smontoyah/criogenia_GICM/README.md

Characterization System for Electronic Components under Cryogenic Conditions

For more information about this project, visit the [WIKI](https://github.com/smontoyah/criogenia_GICM/wiki)!
