smontoyah/criogenia_GICM/0.5cm_interfaz_3_minutos.png

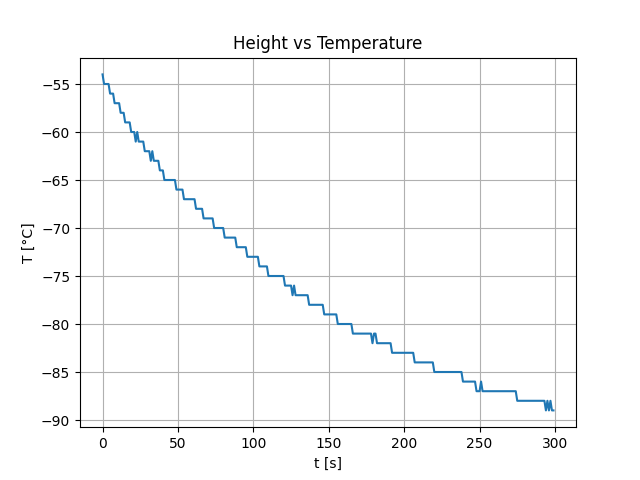
0.5cm_interfaz_3_minutos.png
