smontoyah/criogenia_GICM/0.5cm_interfaz_10min.png

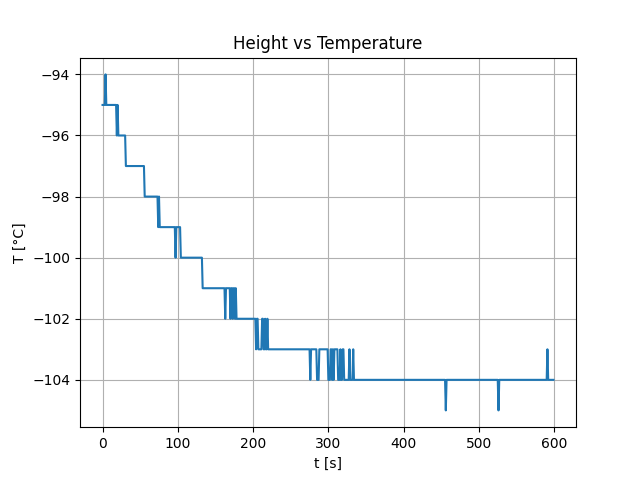
0.5cm_interfaz_10min.png
