smontoyah/criogenia_GICM/0.5cm_interfaz_20min.png

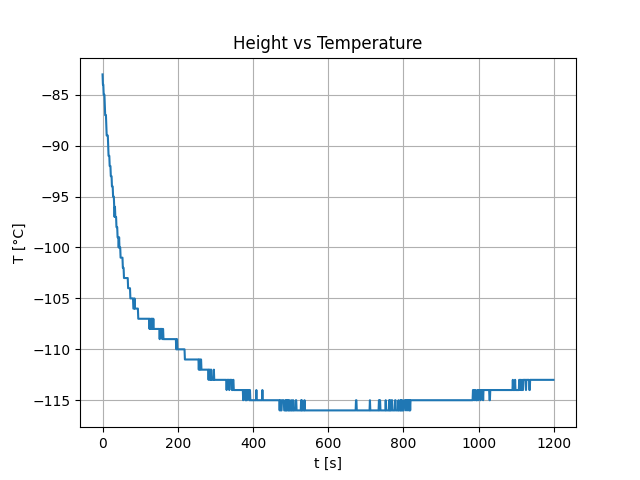
0.5cm_interfaz_20min.png
