smontoyah/criogenia_GICM/curva_calentamiento_termocupla_26_09.png

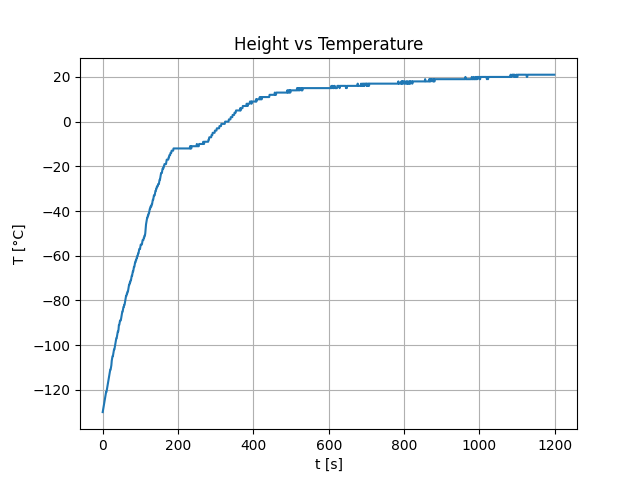
curva_calentamiento_termocupla_26_09.png
