smontoyah/criogenia_GICM/Test4_2023-09-22/Test4_2023-09-22.csv

Altura (cm) | Temperatura (C)
0 | 160.0
1.0 | 152.0
2.0 | 146.0
3.0 | 140.0
4.0 | 134.0
5.0 | 130.0
6.0 | 125.0
7.0 | 121.0
8.0 | 117.0
9.0 | 115.0
10.0 | 111.0
11.0 | 109.0
12.0 | 106.0
13.0 | 103.0
14.0 | 101.0
15.0 | 99.0
16.0 | 97.0
17.0 | 95.0
18.0 | 94.0
19.0 | 92.0
20.0 | 90.0
21.0 | 88.0
22.0 | 87.0
23.0 | 86.0
24.0 | 84.0
25.0 | 83.0
26.0 | 82.0
27.0 | 81.0
28.0 | 80.0
29.0 | 79.0
