smontoyah/criogenia_GICM/src/TEST2_2023-09-26/TEST2_2023-09-26.csv

Altura (cm) | Temperatura (C)
0 | -2.0
1.0 | -13.0
2.0 | -25.0
3.0 | -36.0
4.0 | -47.0
5.0 | -57.0
6.0 | -67.0
7.0 | -107.0
8.0 | -167.0
9.0 | -223.0
