smontoyah/criogenia_GICM/src/TEST8_2023-09-26/TEST8_2023-09-26.csv

Altura (cm) | Temperatura (C)
0 | -8.0
2.0 | -7.0
4.0 | -8.0
6.0 | -9.0
8.0 | -10.0
10.0 | -12.0
12.0 | -13.0
14.0 | -25.0
16.0 | -48.0
18.0 | -76.0
20.0 | -99.0
22.0 | -120.0
