smontoyah/criogenia_GICM/src/TEST1_LN_2023-09-26/TEST1_LN.txt

Nombre de la Prueba: TEST1_LN
Nombre del Experimentador: Sebastian
Fecha y Hora de la Prueba: 2023-09-26 11:51:11
Altura Total de Barrido (cm): 25.0
Intervalo (segundos): 10.0
Valor de paso de motor (cm): -1.0
Valores del Multimetro 1: [17.0, 17.0, 17.0, 16.0, 15.0, 12.0, 9.0, 6.0, 2.0, -1.0, -5.0, -10.0, -15.0, -20.0, -25.0, -60.0, -94.0, -123.0, -146.0, -167.0, -186.0, -221.0, -223.0, -223.0, -223.0]
