smontoyah/criogenia_GICM/Prueba_LN_26_09.xlsx

H (cm) | Z (cm) | T (°C) | P (militorr) | Hora | Evaporación del LN
14,9 | 8.5 | -4 | 54 | 10:29:00 | z (cm) | Hora
 | 5.5 | -18 | 67 |  | 8.5 | 10:29:00
 | 5.5 | -27 | 67 |  | 9 | 10:38:00
18 | 5.5 | -31 | 68 | 10:42:00 | 19.5 | 13:03:00
18 | 5.5 | -37 | 68 | 10:43:00 | 24 | 13:54:00
18 | 5.5 | -40 | 69 | 10:44:00 | 32 | 16:17:00
18 | 5.5 | -41 | 69 | 10:45:00 | 35 | 17:03:00
19 | 5.5 | -43 | 70 | 10:46:00
19 | 4.5 | -44 | 70 | 10:47:00
19 | 4.5 | -47 |  | 10:48:00
19 | 4.5 | -51 | 71 | 10:49:00
19 | 4.5 | -54 | 71 | 10:50:00
20.1 | 4 | -58 | 72 | 10:52:00
20.1 | 4 | -61 | 73 | 10:54:00
20.1 | 4 | -64 | 73 | 10:55:00
21.2 | 3 | -67 | 73 | 10:58:00
21.2 | 3 | -71 | 75 | 11:00:00
21.2 | 3 | -73 | 75 | 11:01:00
21.2 | 3 | -74 | 76 | 11:02:00
21.2 | 3 | -76 | 77 | 11:04:00
21.2 | 3 | -77 | 77 | 11:06:00
22.3 | 2 | -78 | 77 | 11:07:00
22.3 | 2 | -81 | 77 | 11:07:00
22.3 | 2 | -83 | 78 | 11:08:00
22.3 | 1 | -85 | 78 | 11:09:00
23.3 | 1 | -88 | 78 | 11:12:00
24.4 | 1 | -91 | 78 | 11:12:00
24.4 | 1 | -95 | 78 | 11:13:00
24.4 | 1 | -96 | 78 | 11:14:00
24.4 | 1 | -99 | 79 | 11:14:00
24.4 | 1 | -100 | 79 | 11:14:00
24.4 | 1 | -102 | 79 | 11:15:00
25 | 0.5 | -105 | 79
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
