smontoyah/criogenia_GICM/src/test_2023-11-02/test.csv

Valor1 | Valor2
93.0 | 117.49
90.0 | 115.3
87.0 | 111.97
87.0 | 108.08
83.0 | 103.95
80.0 | 99.8
78.0 | 94.48
76.0 | 90.61
74.0 | 86.92
73.0 | 82.69
71.0 | 79.55
69.0 | 76.81
68.0 | 73.47
67.0 | 71.07
65.0 | 68.84
64.0 | 66.31
63.0 | 64.46
62.0 | 62.13
62.0 | 60.73
60.0 | 59.16
59.0 | 57.76
59.0 | 56.67
57.0 | 55.47
57.0 | 54.24
56.0 | 53.25
55.0 | 51.99
54.0 | 51.04
53.0 | 50.22
53.0 | 49.16
52.0 | 48.34
51.0 | 47.66
51.0 | 46.71
51.0 | 46.13
50.0 | 45.52
49.0 | 44.97
