smontoyah/criogenia_GICM/src/TEST1_LN_2023-09-26/TEST1_LN.png

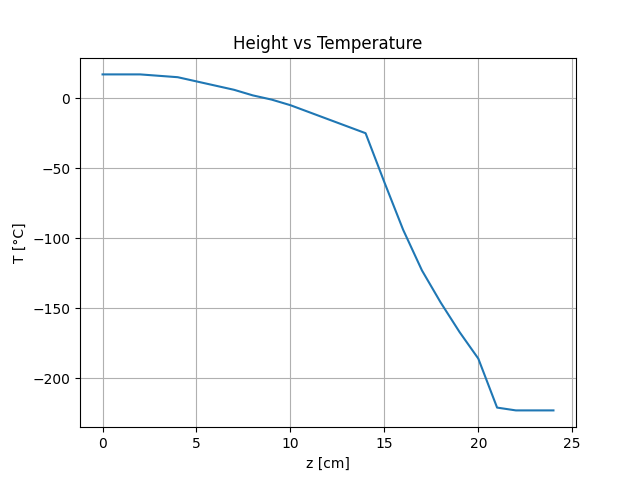
src/TEST1_LN_2023-09-26/TEST1_LN.png
