smontoyah/criogenia_GICM/src/TEST2_2023-09-26/TEST2.png

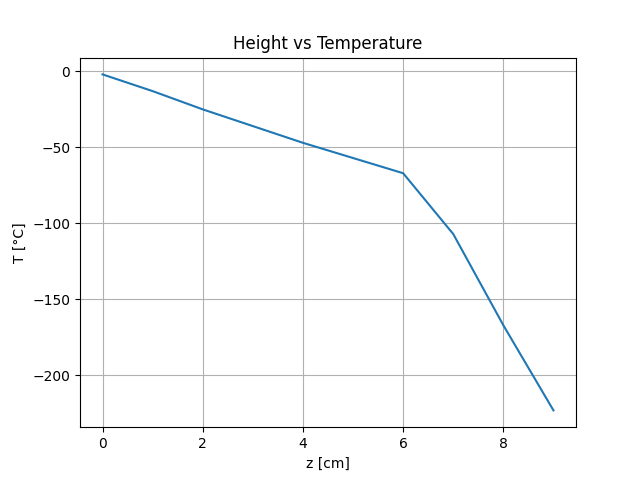
src/TEST2_2023-09-26/TEST2.png
