smontoyah/criogenia_GICM/src/TEST8_2023-09-26/TEST8.png

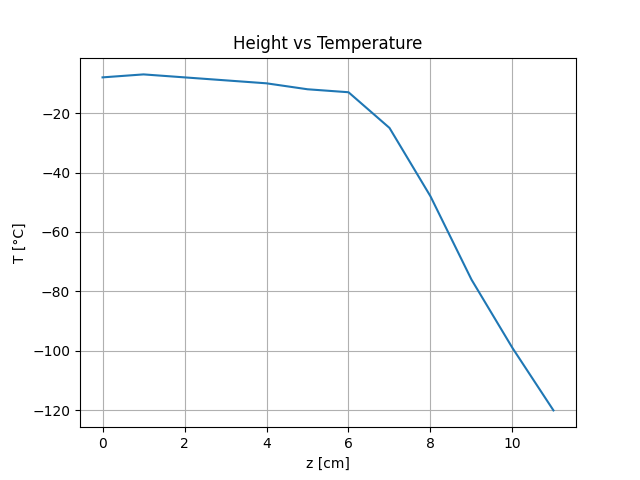
src/TEST8_2023-09-26/TEST8.png
