smontoyah/criogenia_GICM/src/test_2023-11-02/test.png

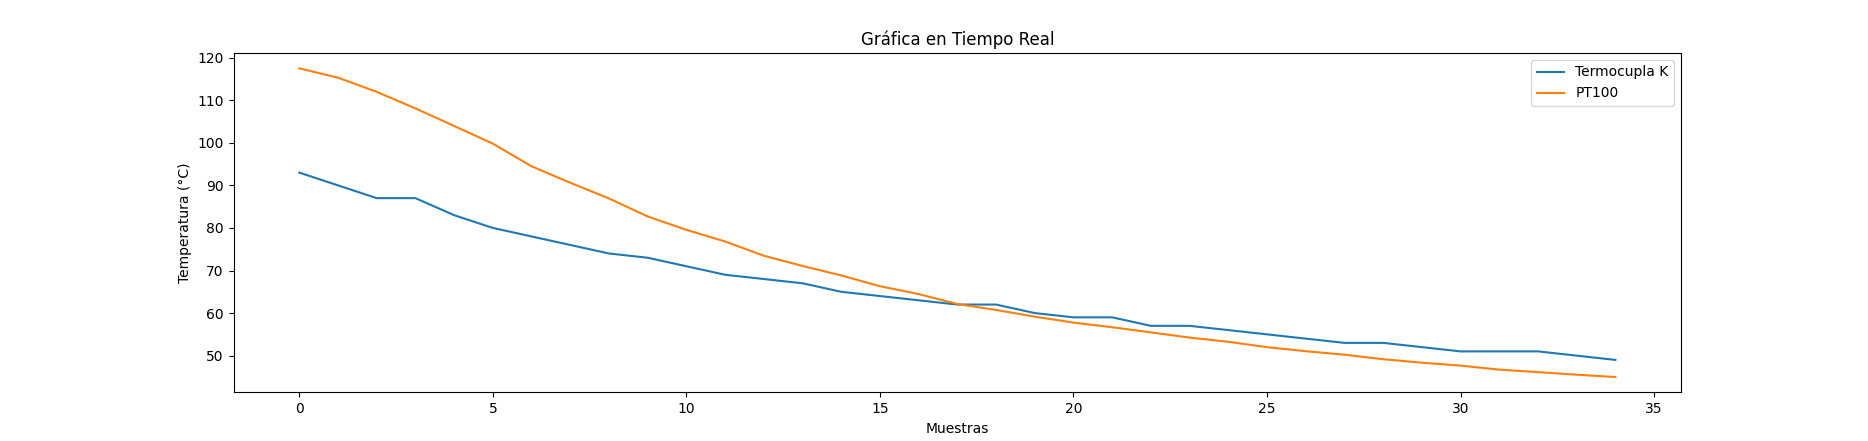
src/test_2023-11-02/test.png
