smontoyah/criogenia_GICM/Test4_2023-09-22/Test4.png

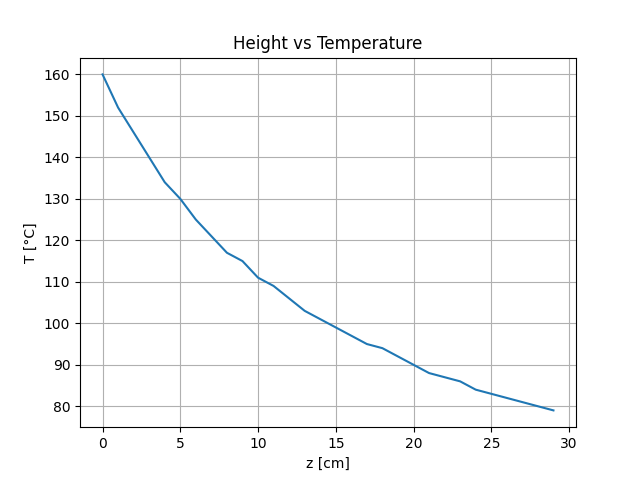
Test4_2023-09-22/Test4.png
